TheLapisGoat/Device-Emulating-Real-Time-Peak-Wavelength-of-Sunlight./README.md

# Device Emulating Real Time Peak Wavelength of Sunlight
(DY17003) DIY Project

## Objective:
To create a device that establishes a user-friendly environment based on the lighting in a room to obtain an optimistic wavelength of light according to the time of the day for the respective user to obtain mental peace and create an environment closest to the natural light. It also allows the user to control the light mode to focus on specific tasks or relax. It is helpful in the modern day because many people spend most of their time indoors during the day.

[Report](./Report.pdf) of the project.
