TheLapisGoat/Device-Emulating-Real-Time-Peak-Wavelength-of-Sunlight./(commit log)

2022-02-20 Combined keypad and output code with logic code, making Final Arduino file
2022-02-20 Merged keypad and logic code, making final arduino file
2022-02-22 Fixed midnight reset of auto
    [src.ino]
2022-02-23 Fixed error in manual mode
    [src.ino]
